SolHunter/Open_CPV_Solar_Tracker_Control/Shading_Beam.STL

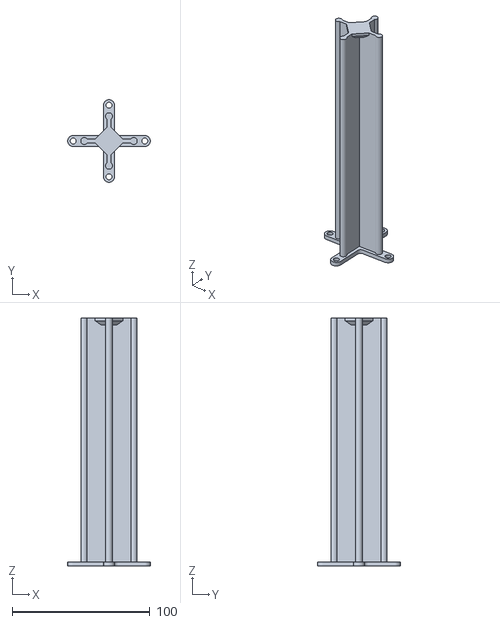
[picture p32: CAD file, 2022-05-01]
Shading_Beam.STL
60.0 x 60.0 x 180.0
