SolHunter/Open_CPV_Solar_Tracker_Control/(threads)

Thread 1 (2024-06-24):

Gratuliere ein tolles Projekt

brandy88, 2024-06-24:
Ein ganz tolles Projekt! Hat bloß nen kleinen Fehler,
Hat leider keine deutsche Dokumentation.
Selbst bei Einsatz von Übersetzungs Software ist es schwierig für einen alten Elektro Meister der englischen Doku zu folgen.
Gibt es da vielleicht ne Lösung?
Bin dabei einen kleinen Solartracker für meine Terrassen Be- und Entlüftung zu bauen, jedes Watt Einsparungen zählt.

Mit freundlichen Grüssen aus Hamburg
Jörg Brand

SolHunter, 2024-06-24:
Guten Tag, Herr Brand. Eine deutsche Doku habe ich leider nicht. Vielleicht ist diese Platine auch etwas zu kompliziert, wenn sie einen kleinen Tracker für Siliziummodule bauen wollen. Da wäre der Klassiker eine analoge Lösung mit 2 Solarzellen, die in Dachform gestellt gegeneinander arbeiten und einen Getriebemotor antreiben. Die Übersetzung der ganzen Doku auf Deutsch würde ich zunächst auch einmal der KI überlassen und dann nur noch korrigieren. Mir fehlt leider dazu die Zeit.

Wie sie sehen, hat meine Steuerung einige Parameter, die zu setzen sind, um ein sehr praises tracking zu ermöglichen. Es kostet in jedem Fall einige Zeit, sich da einzudenken - deutsch oder nicht. Wollen sie wirklich 2 achsig tracken? 1 achsig ist für Flachmodule kaum schlechter und mechanisch viel einfacher.

Viele Grüße!

SolHunter, 2024-06-25:
Here is more information

https://hackaday.io/project/185130-open-concentrating-pv-solar-tracker-controller

https://www.pcbway.com/project/shareproject/Open_Concentrator_Photovoltaics_CPV_Solar_Tracker_Controller_Board_18449b11.html

Regards, viele Grüße!
