SolHunter/Open_CPV_Solar_Tracker_Control/(commit log)

2021-05-30 Add files via upload
    Assembly instructions and operation manual
2021-06-06 Add files via upload
    corrected wrong trace and added detailed discription of housing
2022-09-04 Improved Sensor Tracking
    Solved issues: Azimuth step size depends on elevation and long time no step for direction reversals (elevation at noon).
